bboser/Zumo-Shield/zumo_V1_FABRICATED_enc_only.brd

## EAGLE design zumo_V1_FABRICATED_enc_only.brd (2017-12-01)

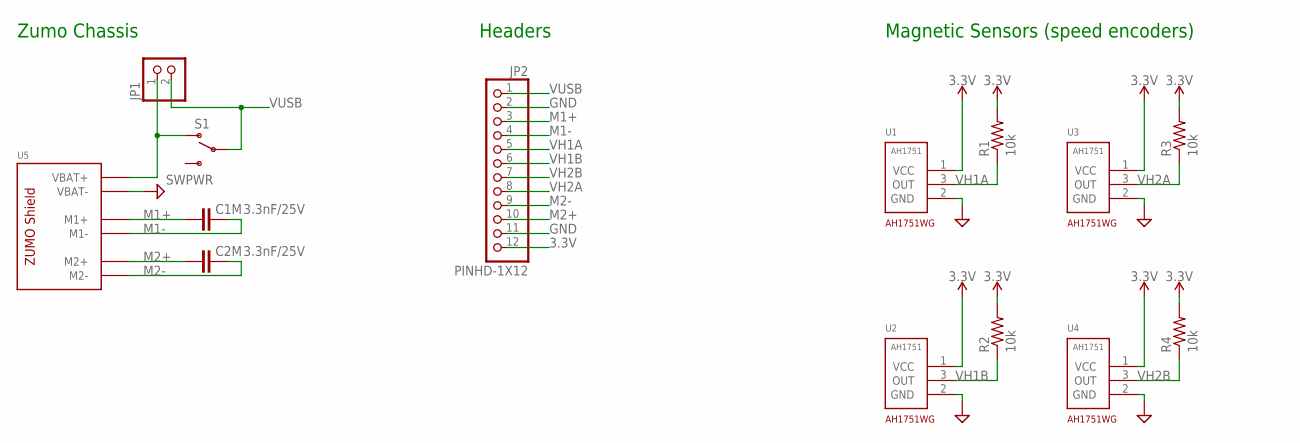
[picture p3: schematic zumo_V1_FABRICATED_enc_only.sch]

Parts:
C1M, C2M: 3.3nF/25V; C0805; DIGIKEY 732-8052-6-ND
JP1: JPWR; 1X02
JP2: PINHD-1X12; 1X12
R1, R2, R3, R4: 10k; R0805
S1: SWPWR; AYZ0202; DIGIKEY 401-2013-6-ND
U1, U2, U3, U4: AH1751WG; SC59
U5: ZUMONO_TABS; ZUMO_NO_TABS

Connections:
3.3V: JP2.12, R1.2, R2.2, R3.2, R4.2, U1.1 (VCC), U2.1 (VCC), U3.1 (VCC), U4.1 (VCC)
GND: JP2.2, JP2.11, U1.2 (GND), U2.2 (GND), U3.2 (GND), U4.2 (GND), U5.VBAT-
M1+: C1M.2, JP2.3, U5.M1+
M1-: C1M.1, JP2.4, U5.M1-
M2+: C2M.2, JP2.10, U5.M2+
M2-: C2M.1, JP2.9, U5.M2-
VBAT: JP1.1, S1.1 (O), U5.VBAT+
VH1A: JP2.5, R1.1, U1.3 (OUT)
VH1B: JP2.6, R2.1, U2.3 (OUT)
VH2A: JP2.8, R3.1, U3.3 (OUT)
VH2B: JP2.7, R4.1, U4.3 (OUT)
VUSB: JP1.2, JP2.1, S1.2

Notes on the sheet:
Zumo Chassis
Magnetic Sensors (speed encoders)
Headers

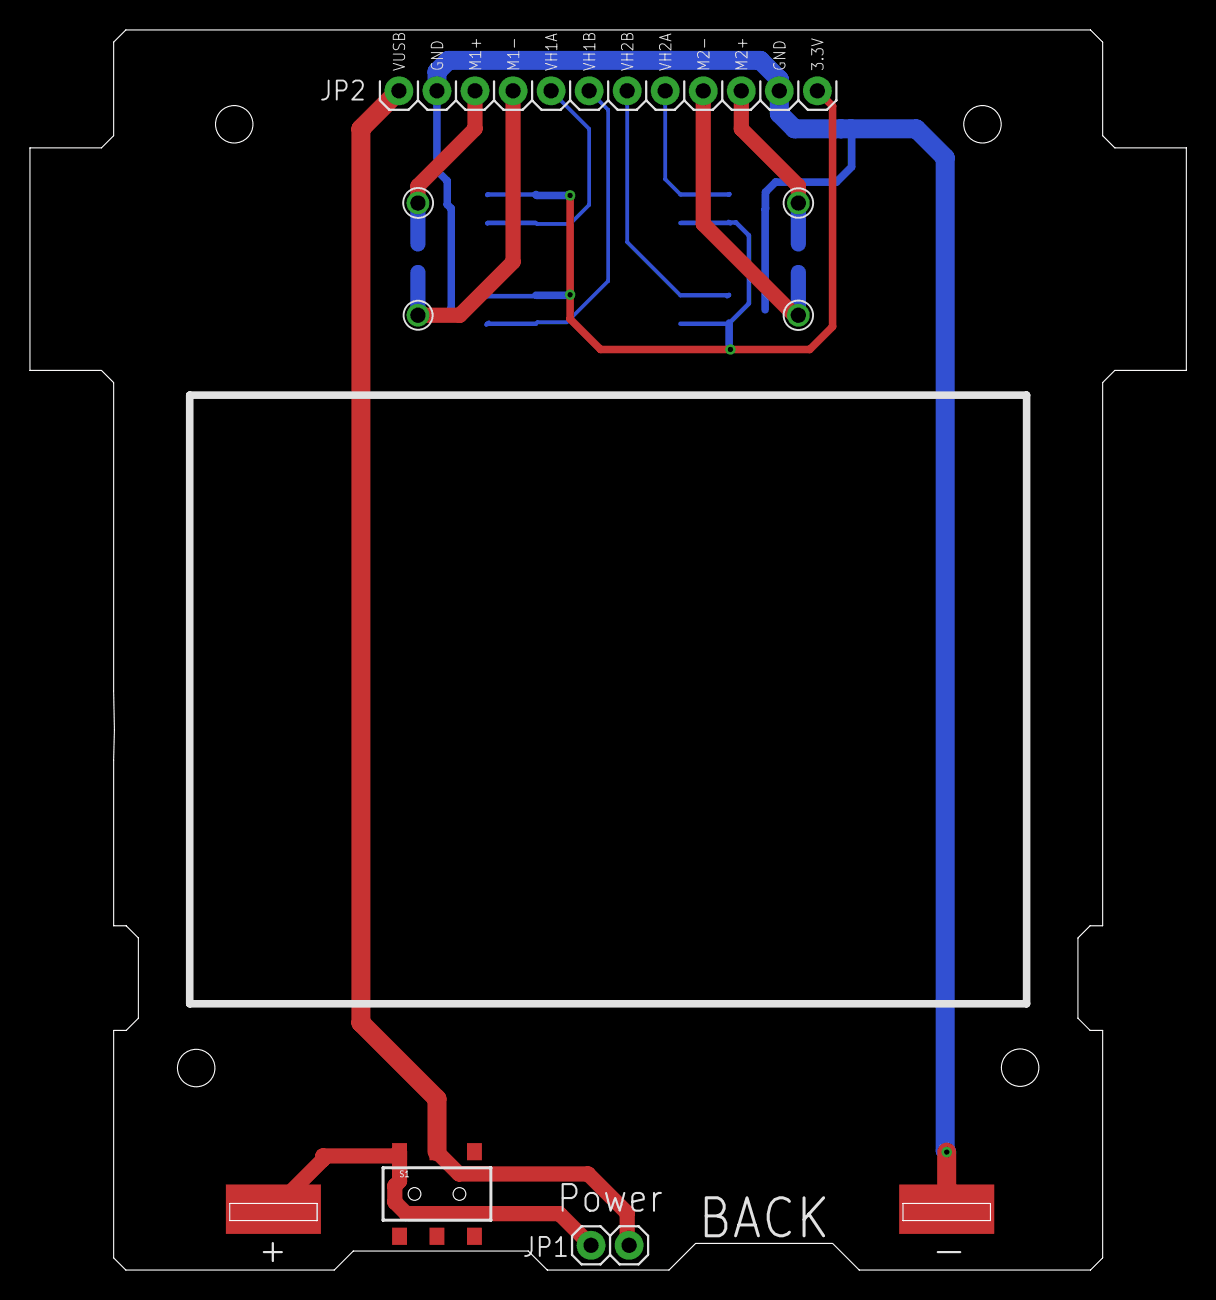
[picture p4: board zumo_V1_FABRICATED_enc_only.brd from above]

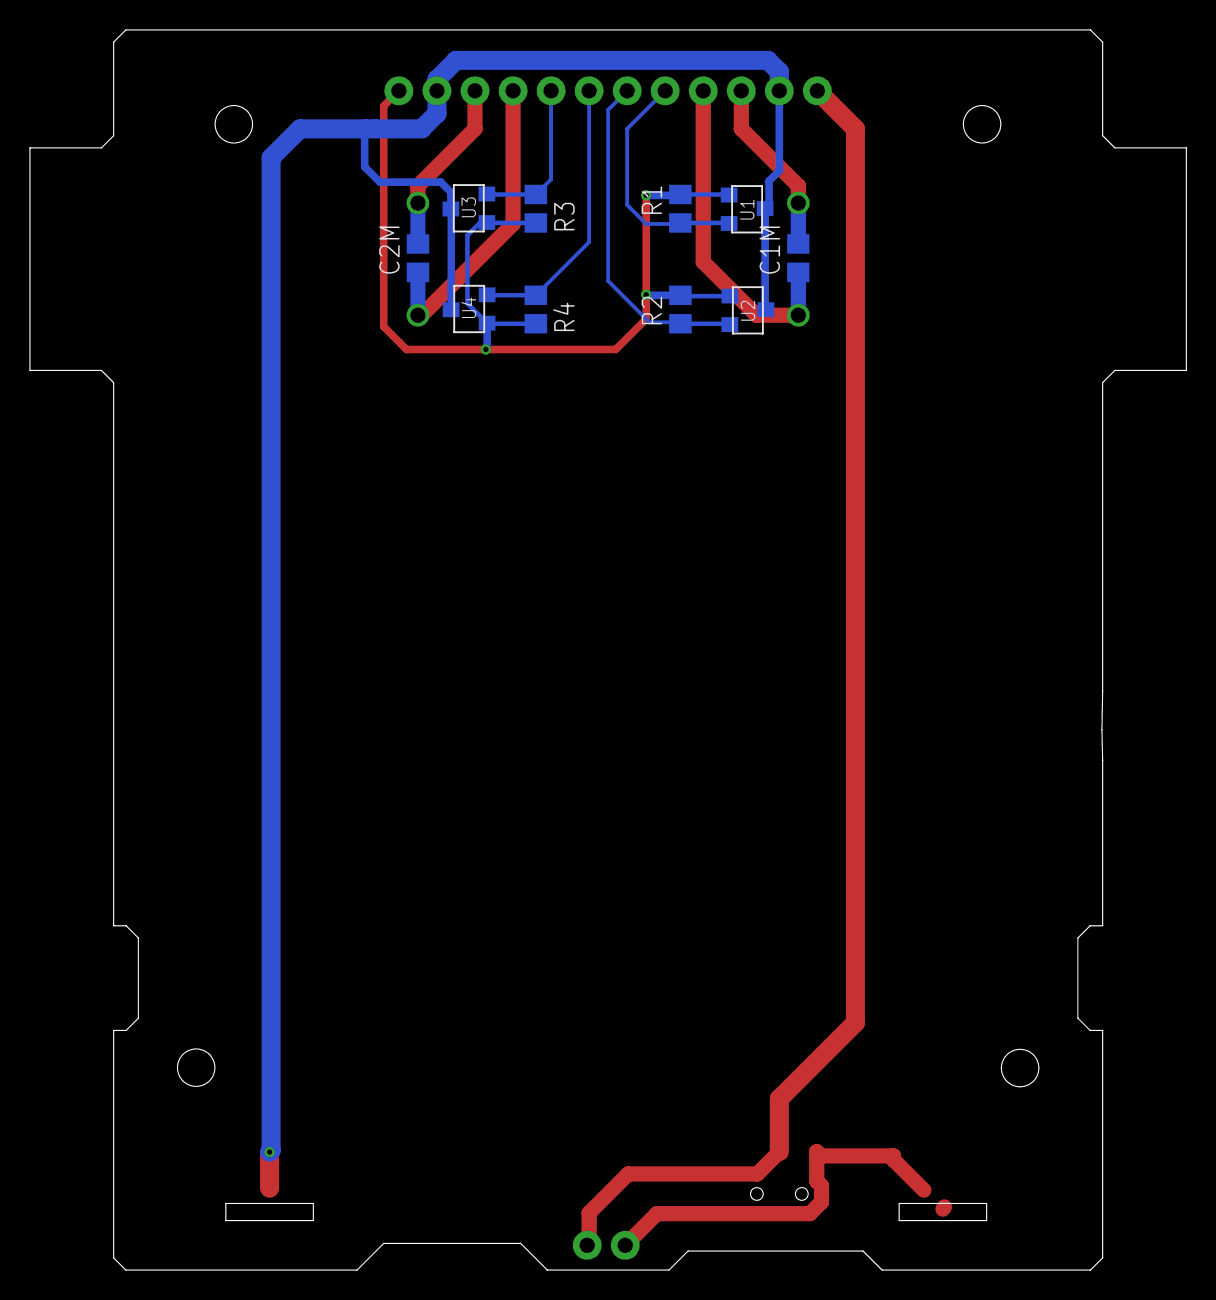
[picture p5: board zumo_V1_FABRICATED_enc_only.brd from below]

Board: 2 copper layers, 77.2 x 82.8 mm, 14 parts (10 on the bottom side), 12 nets.
